poe-lab/InsightMaze/README.md

# InsightMaze
C++ code for running automated maze.
The code in this folder is pseudo code to practice 
with the different components of the insight maze.
