poe-lab/InsightMaze/MockMaze_run/README.txt

The code in this folder is pseudo code to practice 
with the different components of the insight maze

4/18/19

Tried rubber - caused too much friction, but did work as intended
	can try moving rubber farther away from door slot
	should show Greg tomorrow

There is one door slot that is too wide 
	can try connecting some rubber to make it work properly
