poe-lab/InsightMaze/Maze Parts/Module Floors/Main Module Floor.STEP

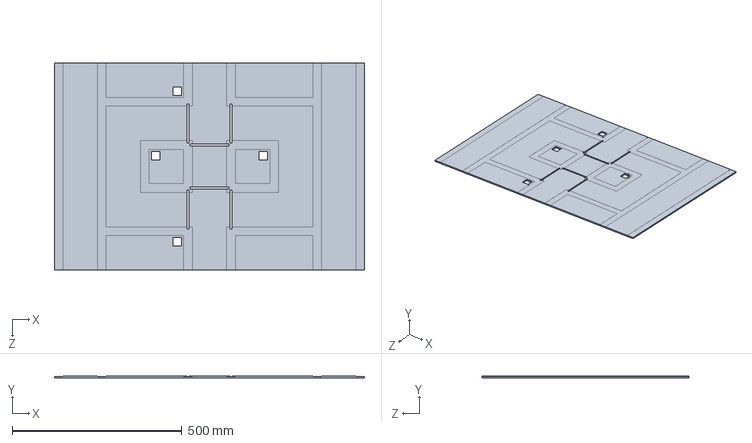
[picture p1: CAD file, 2019-07-17]
Maze Parts/Module Floors/Main Module Floor.STEP
914.4 x 4.76 x 609.6 mm
