poe-lab/InsightMaze/Maze Parts/Doors/Door Guide Rail Profile.dxf

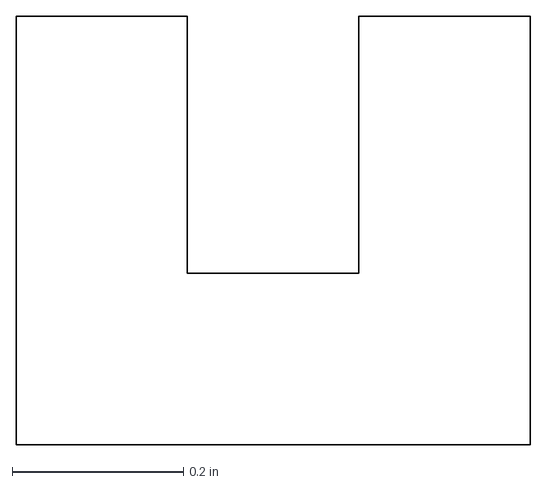
[picture p2: CAD file, 2019-07-17]
Maze Parts/Doors/Door Guide Rail Profile.dxf
0.6 x 0.5 in
