poe-lab/InsightMaze/Maze Parts/Joints and Braces/4 Way Wall Wall Joint Profile.dxf

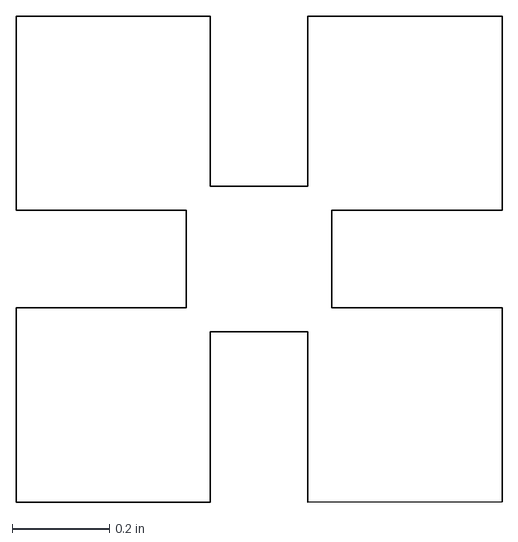
[picture p3: CAD file, 2019-07-17]
Maze Parts/Joints and Braces/4 Way Wall Wall Joint Profile.dxf
1 x 1.00 in
