poe-lab/InsightMaze/Maze Parts/Rewards Dispenser/Rewards Dispenser.STEP

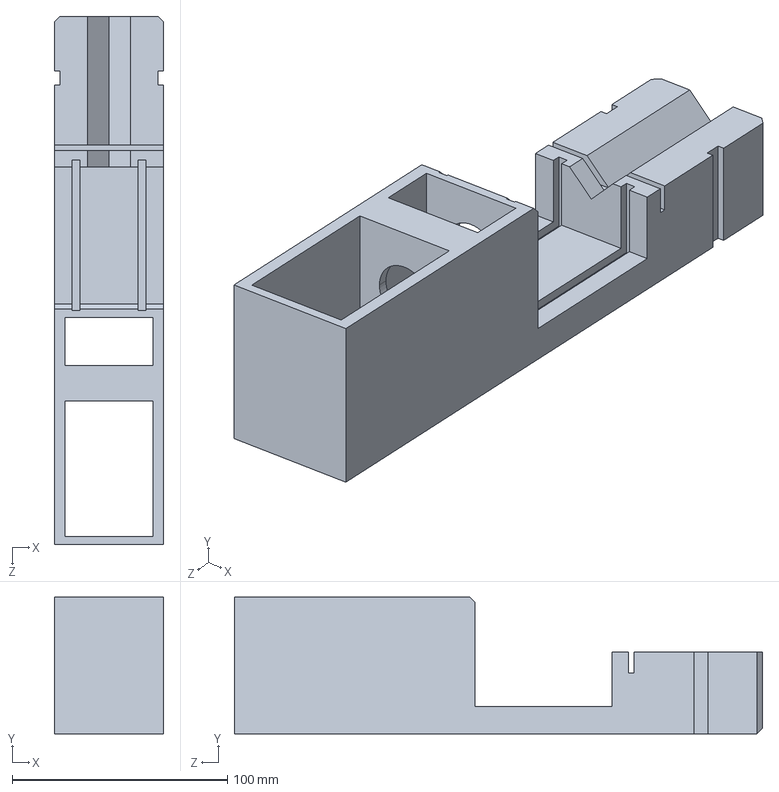
[picture p4: CAD file, 2019-07-17]
Maze Parts/Rewards Dispenser/Rewards Dispenser.STEP
50.8 x 63.5 x 245.1 mm
