poe-lab/InsightMaze/Maze Parts/Doors/Door Cap.STEP

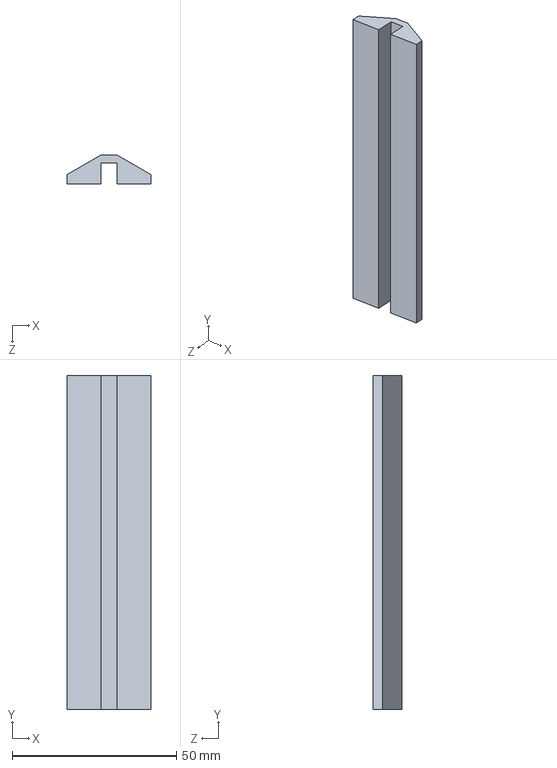
[picture p5: CAD file, 2019-07-17]
Maze Parts/Doors/Door Cap.STEP
25.4 x 101.6 x 8.89 mm
