poe-lab/InsightMaze/Maze Parts/Joints and Braces/2-Way Wall Brace.STEP

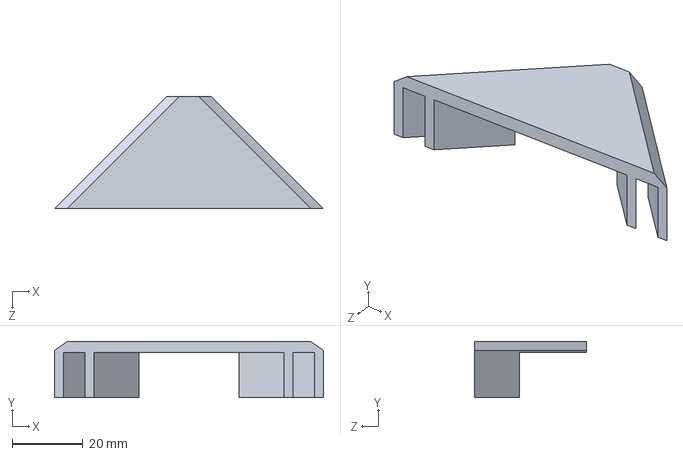
[picture p6: CAD file, 2019-07-17]
Maze Parts/Joints and Braces/2-Way Wall Brace.STEP
76.2 x 15.9 x 31.8 mm
