poe-lab/InsightMaze/Maze Parts/Module Floors/Start Module Floor.STEP

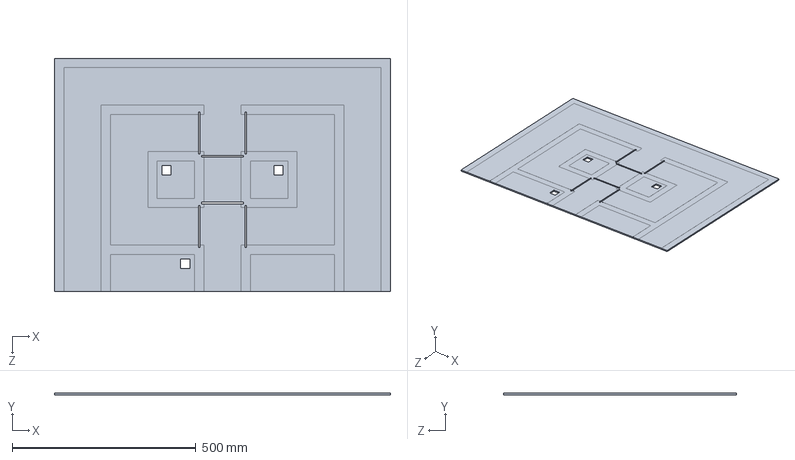
[picture p7: CAD file, 2019-07-17]
Maze Parts/Module Floors/Start Module Floor.STEP
914.4 x 4.76 x 635.0 mm
