poe-lab/InsightMaze/Maze Parts/Rewards Dispenser/Syringe Attachment.STEP

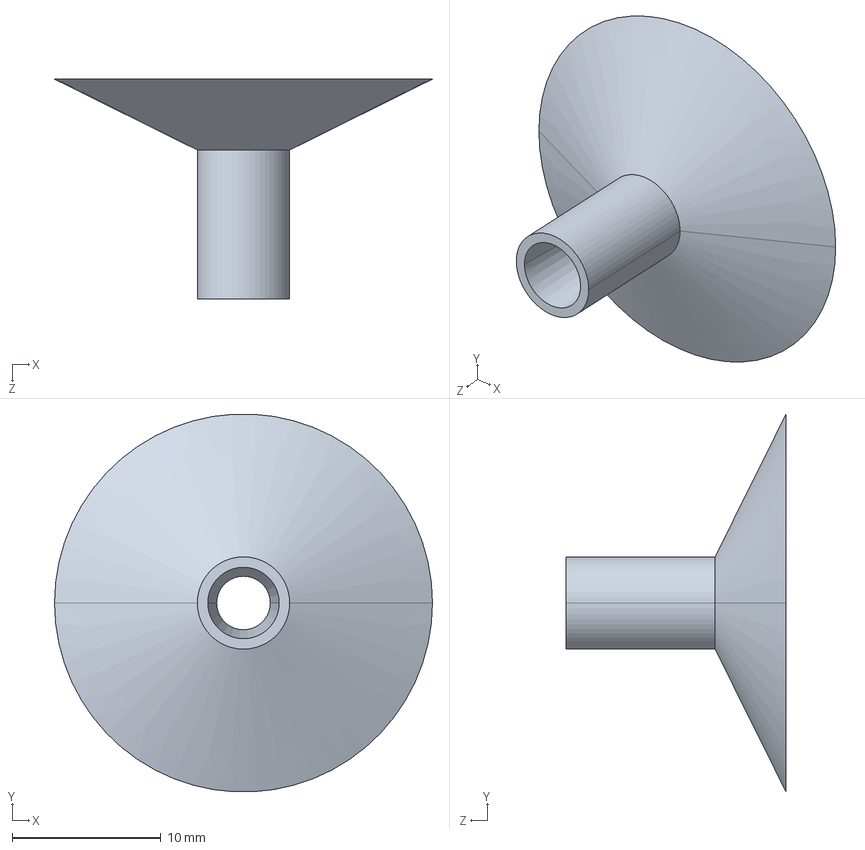
[picture p8: CAD file, 2019-07-17]
Maze Parts/Rewards Dispenser/Syringe Attachment.STEP
25.4 x 25.4 x 14.8 mm
