poe-lab/InsightMaze/Maze Parts/Doors/Door Arm Opposite Side.STEP

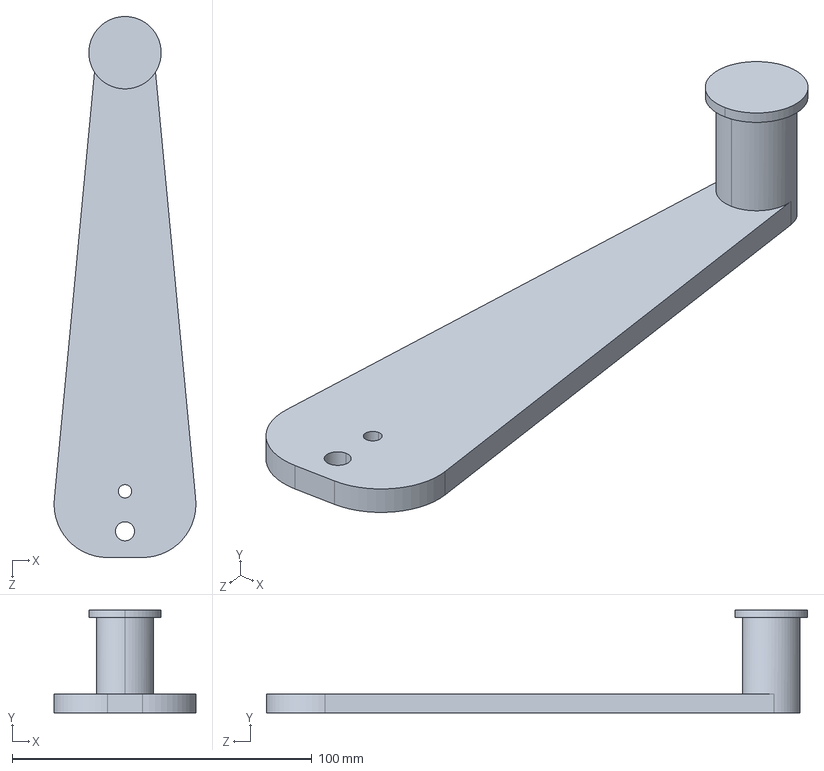
[picture p9: CAD file, 2019-07-17]
Maze Parts/Doors/Door Arm Opposite Side.STEP
47.3 x 34.3 x 180.3 mm
