poe-lab/InsightMaze/Maze Parts/Joints and Braces/3-Way Wall Brace.STEP

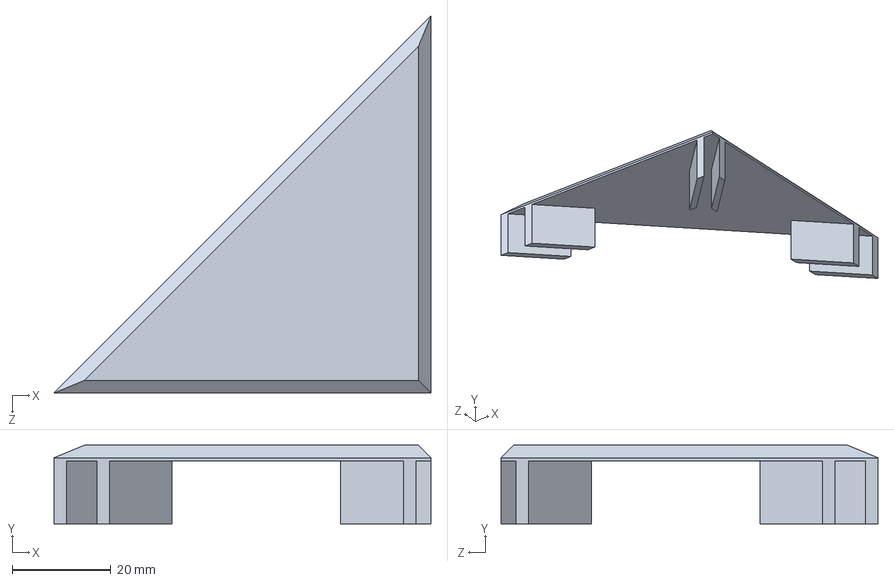
[picture p10: CAD file, 2019-07-17]
Maze Parts/Joints and Braces/3-Way Wall Brace.STEP
76.2 x 15.9 x 76.2 mm
