poe-lab/InsightMaze/Maze Parts/Rewards Dispenser/Wall for Rewards Dispenser.STEP

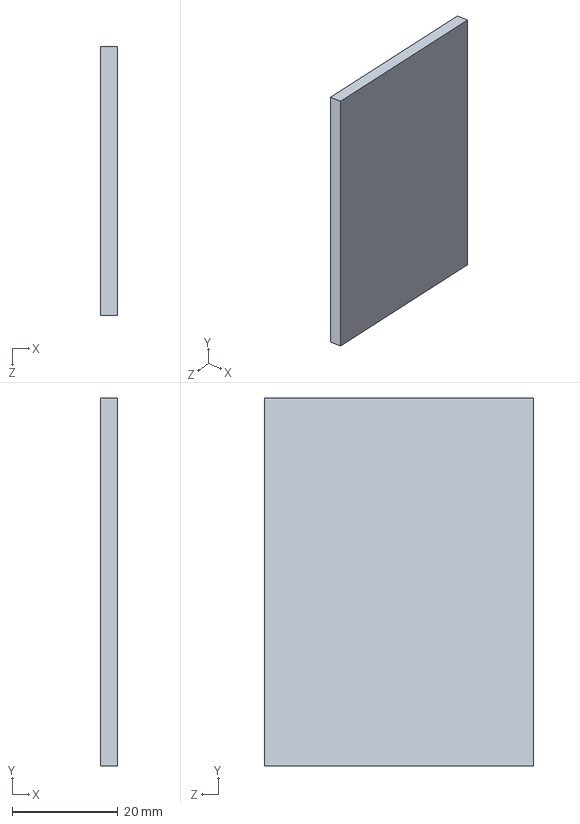
[picture p11: CAD file, 2019-07-17]
Maze Parts/Rewards Dispenser/Wall for Rewards Dispenser.STEP
3.17 x 69.6 x 50.8 mm
