poe-lab/InsightMaze/Maze Parts/Doors/Single Door Guide Rail Mount.step

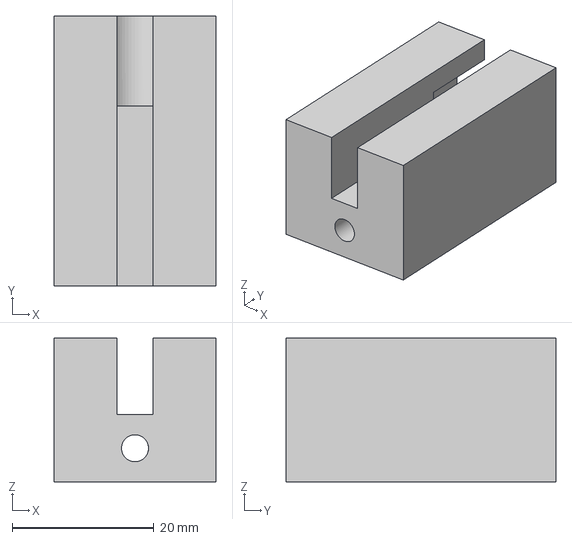
[picture p12: CAD file, 2019-07-17]
Maze Parts/Doors/Single Door Guide Rail Mount.step
22.9 x 38.1 x 20.3 mm
