poe-lab/InsightMaze/Maze Parts/Rewards Dispenser/Shim for Rewards Dispenser.STEP

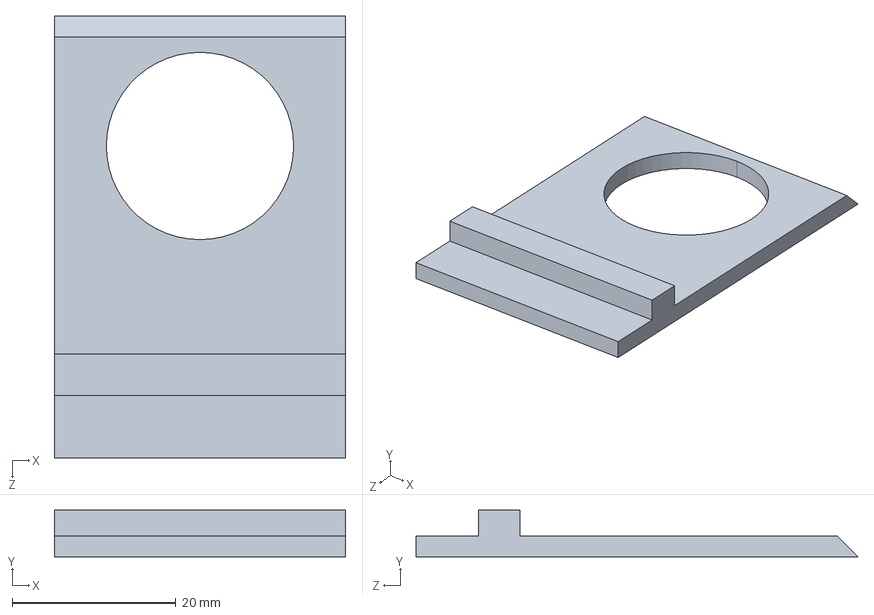
[picture p14: CAD file, 2019-07-17]
Maze Parts/Rewards Dispenser/Shim for Rewards Dispenser.STEP
35.6 x 5.71 x 54.0 mm
