poe-lab/InsightMaze/Maze Parts/Joints and Braces/3 Way Wall Wall Joint Profile.dxf

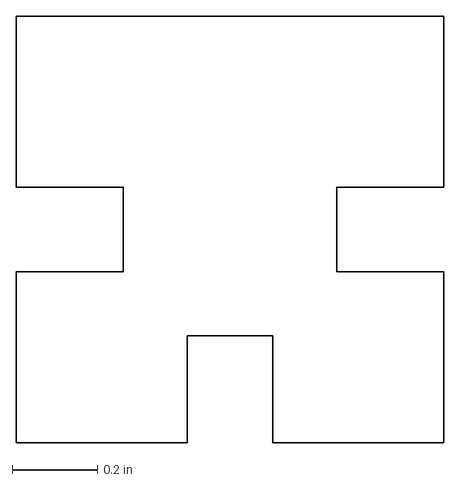
[picture p15: CAD file, 2019-07-17]
Maze Parts/Joints and Braces/3 Way Wall Wall Joint Profile.dxf
1.00 x 0.998 in
