poe-lab/InsightMaze/Maze Parts/Rewards Dispenser/Pusher for Rewards Dispenser.STEP

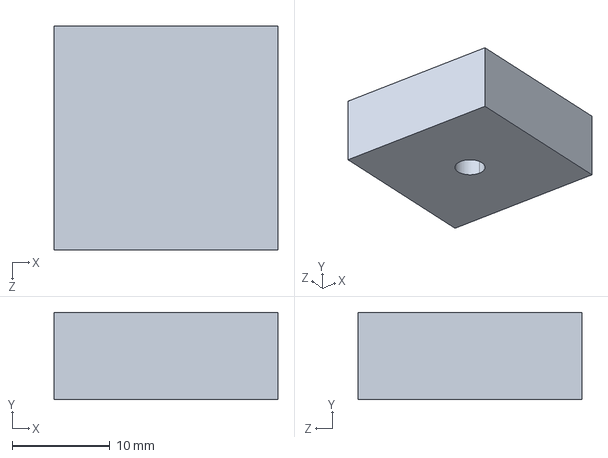
[picture p16: CAD file, 2019-07-17]
Maze Parts/Rewards Dispenser/Pusher for Rewards Dispenser.STEP
22.9 x 8.89 x 22.9 mm
