poe-lab/InsightMaze/Maze Parts/Joints and Braces/Floor Wall Joint Profile.dxf

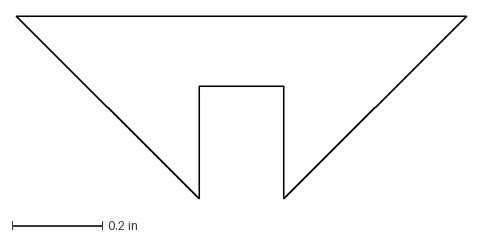
[picture p17: CAD file, 2019-07-17]
Maze Parts/Joints and Braces/Floor Wall Joint Profile.dxf
1 x 0.406 in
