poe-lab/InsightMaze/(list of files, cad)

Other CAD files:
Maze Parts/Module Floors/End Module Floor.STEP
Maze Parts/Doors/Door Arm Same Side.STEP
