poe-lab/InsightMaze/Insight_Maze_Master_Control_System/Insight_Maze_Master_Control_System.ino

#include "InsightMazeMaster.h"
#include "globals.h"

Master ma(PINS_ID_OUT, PIN_BTN, PIN_SD_CS, PIN_ALERT_IN);

void setup() {
  // put your setup code here, to run once:
  ma.masterSetup();
  attachInterrupt(digitalPinToInterrupt(ma.pinAlertIn()), sendPulse, CHANGE);
  
  pinMode(13, OUTPUT);
  digitalWrite(13, HIGH);
  pinMode(40, OUTPUT);
  pinMode(PIN_ALERT_OUT, OUTPUT);
  Serial.println("Waiting for button press...");
}

void loop() {
  // put your main code here, to run repeatedly:
  
  ma.sctProtocol(1);
  digitalWrite(40, HIGH);
  delay(2000);
  digitalWrite(40, LOW);

  
  Serial.println("Finished loop");

}

void sendPulse(){
  digitalWrite(PIN_ALERT_OUT, HIGH);
  delayMicroseconds(PULSE_DURATION);
  digitalWrite(PIN_ALERT_OUT, LOW);
}
