poe-lab/InsightMaze/Insight_Maze_Control_System/InsightMaze.cpp

#include <Arduino.h>
#include "InsightMaze.h"

//////////////////////////// MAIN MODULE CLASS ///////////////////////////////////////////

Module::Module(int pinID, Sensor s0, Sensor s1, Sensor s2, Sensor s3, Door d0, Door d1, Door d2, Door d3, Door d4, Door d5)
  : m_s0(s0), m_s1(s1), m_s2(s2), m_s3(s3), m_d0(d0), m_d1(d1), m_d2(d2), m_d3(d3), m_d4(d4), m_d5(d5) 
{
  m_pinID = pinID;
  
  m_s0 = s0;
  m_s1 = s1;
  m_s2 = s2;
  m_s3 = s3;
  m_sensors[0] = &m_s0;
  m_sensors[1] = &m_s1;
  m_sensors[2] = &m_s2;
  m_sensors[3] = &m_s3;

  m_d0 = d0;
  m_d1 = d1;
  m_d2 = d2;
  m_d3 = d3;
  m_d4 = d4;
  m_d5 = d5;
  m_doors[0] = &m_d0;
  m_doors[1] = &m_d1;
  m_doors[2] = &m_d2;
  m_doors[3] = &m_d3;
  m_doors[4] = &m_d4;
  m_doors[5] = &m_d5;
}

void Module::moduleSetup(){
  Serial.begin(9600);
  
  Serial.println("Setting Up Sensors...");
  // Calls setup fuinction for all sensors
  for(int i = 0; i < NUM_MAIN_SENSORS; i++)
    m_sensors[i]->sensorSetup();
    
  Serial.println("Setting Up Doors...");
  // Calls setup function for all doors
  for(int i = 0; i < NUM_MAIN_DOORS; i++)
    m_doors[i]->doorSetup();
  
  m_needsToConfig = true;

  Serial.println("Deteriming Module ID...");
  
  // Determines ID char of Module
  int idValIn = analogRead(m_pinID);
  Serial.print("ID Input Val: "); Serial.println(idValIn);
  
  char id = 'n';

  for(int i = 0; i < NUM_IDS; i++) {
    if(idValIn >= ID_VALS_IN[i] - ID_RES && idValIn <= ID_VALS_IN[i] + ID_RES)
      m_id = IDS[i];
  }
  Serial.print("Module ID: "); Serial.println(m_id);

  Serial.println("Testing Doors...");

  testDoors(1500, 1500);
}

void Module::openDoor(int doorID){
  m_doors[doorID]->doorOpen();
}

void Module::closeDoor(int doorID){
  m_doors[doorID]->doorClose();
}

bool Module::isDoorOpen(int doorID){
  return (m_doors[doorID]->isOpen());
}

void Module::openAllDoors(){
  for(int i = 0; i < NUM_MAIN_DOORS; i++) openDoor(i);
}

void Module::closeAllDoors(){
  for(int i = 0; i < NUM_MAIN_DOORS; i++) closeDoor(i);
}
    
void Module::testDoors(int closeTime, int openTime){
  closeAllDoors();
  delay(closeTime);
  openAllDoors();
  delay(openTime);
}

void Module::printDoorsStates() {
  Serial.print("dState:");
  for(int i = 0; i < NUM_MAIN_DOORS; i++){
    Serial.print(isDoorOpen(i));
    if(i == NUM_MAIN_DOORS - 1) Serial.print(" - ");
    else Serial.print(',');
  }
}

void Module::setPath(int path){
  switch (path){
    case LEFT:
      for(int i = 0; i < NUM_MAIN_DOORS; i++){
        if(i == 0 || i == 3) openDoor(i);
        else closeDoor(i);
      }
      break;

    case CENTER:
      for(int i = 0; i < NUM_MAIN_DOORS; i++){
        if(i == 1 || i == 4) openDoor(i);
        else closeDoor(i);
      }
      break;

    case RIGHT:
      for(int i = 0; i < NUM_MAIN_DOORS; i++){
        if(i == 2 || i == 5) openDoor(i);
        else closeDoor(i);
      }
      break;
  }
}

int Module::getSensorVal(int sensorID){
  return (m_sensors[sensorID]->getSensorVal());
}

void Module::updateSensors(){
  for(int i = 0; i < NUM_MAIN_SENSORS; i++){
    m_sensors[i]->sensorUpdate();
  }
}

bool Module::isSensorFall(int sensorID){
  return (m_sensors[sensorID]->isFallEdge());
}

bool Module::isSensorRise(int sensorID){
  return (m_sensors[sensorID]->isRiseEdge());
}

int Module::getSensorThresh(int sensorID){
  return (m_sensors[sensorID]->getThreshold());
}

bool Module::isObjInSensorView(int sensorID){
  return (m_sensors[sensorID]->isPastThresh());
}

bool Module::wasObjInSensorView(int sensorID){
  return (m_sensors[sensorID]->wasPastThresh());
}

void Module::printSensorsVals() {
  Serial.print("sVal:");
  for(int i = 0; i < NUM_MAIN_SENSORS; i++){
    Serial.print(getSensorVal(i));
    if(i == NUM_MAIN_SENSORS - 1) Serial.print(" - ");
    else Serial.print(',');
  }
}

void Module::printIsObjSensorView() {
  Serial.print("isObj:");
  for(int i = 0; i < NUM_MAIN_SENSORS; i++){
    Serial.print(isObjInSensorView(i));
    if(i == NUM_MAIN_SENSORS - 1) Serial.print(" - ");
    else Serial.print(',');
  }
}

void Module::printWasObjSensorView() {
  Serial.print("wasObj:");
  for(int i = 0; i < NUM_MAIN_SENSORS; i++){
    Serial.print(wasObjInSensorView(i));
    if(i == NUM_MAIN_SENSORS - 1) Serial.print(" - ");
    else Serial.print(',');
  }
}

void Module::printSensorsIsFall() {
  Serial.print("isFall:");
  for(int i = 0; i < NUM_MAIN_SENSORS; i++){
    Serial.print(isSensorFall(i));
    if(i == NUM_MAIN_SENSORS - 1) Serial.print(" - ");
    else Serial.print(',');
  }
}

void Module::printSensorsIsRise() {
  Serial.print("isRise:");
  for(int i = 0; i < NUM_MAIN_SENSORS; i++){
    Serial.print(isSensorRise(i));
    if(i == NUM_MAIN_SENSORS - 1) Serial.print(" - ");
    else Serial.print(',');
  }
}

void Module::printSensorsThresh(){
  Serial.print("sThresh:");
  for(int i = 0; i < NUM_MAIN_SENSORS; i++){
    Serial.print(getSensorThresh(i));
    if(i == NUM_MAIN_SENSORS - 1) Serial.print(" - ");
    else Serial.print(',');
  }
}

void Module::testSensors(int values) {
  if(bitRead(values, 0)) printSensorsVals();
  if(bitRead(values, 1)) printSensorsThresh();
  if(bitRead(values, 2)) printIsObjSensorView();
  if(bitRead(values, 3)) printWasObjSensorView();
  if(bitRead(values, 4)) printSensorsIsFall();
  if(bitRead(values, 5)) printSensorsIsRise();
  Serial.println(' ');
}

char Module::id(){
  return m_id;
}

unsigned int Module::receiveCommands() {
  String receiving = Serial.readStringUntil('\n');
  unsigned int recCommands = 0;
  char charCommands[25];
  String strCommands = "";
  
  if(receiving.length() == 25) {
    receiving.toCharArray(charCommands, 25);

    for(int i = 0; i < receiving.length(); i++)
      if(charCommands[i] == m_id){ 
        strCommands += charCommands[i+1];
        strCommands += charCommands[i+2];
        strCommands += charCommands[i+3];
        recCommands = strCommands.toInt();
      }
  }
  
  return recCommands;
}

void Module::interpretCommands(unsigned int commands){
  unsigned int protocol = (commands & 0b11000000) >> 6;
}

//////////////////////////////////////////////////////////////////////////


/////////////////// End Module Class ////////////////////////////////////
EndModule::EndModule(int pinID, int pinAlertOut, Sensor s0, Sensor s1, Sensor s2, Door d0, Door d1, Door d2, Door d3, Door d4, Door d5, SyringePump r0, SyringePump r1, SyringePump r2)
  : m_s0(s0), m_s1(s1), m_s2(s2), m_d0(d0), m_d1(d1), m_d2(d2), m_d3(d3), m_d4(d4), m_d5(d5), m_r0(r0), m_r1(r1), m_r2(r2)
{
  m_pinID = pinID;
  m_pinAlertOut = pinAlertOut;
  
  m_s0 = s0;
  m_s1 = s1;
  m_s2 = s2;
  m_sensors[0] = &m_s0;
  m_sensors[1] = &m_s1;
  m_sensors[2] = &m_s2;

  m_d0 = d0;
  m_d1 = d1;
  m_d2 = d2;
  m_d3 = d3;
  m_d4 = d4;
  m_d5 = d5;
  m_doors[0] = &m_d0;
  m_doors[1] = &m_d1;
  m_doors[2] = &m_d2;
  m_doors[3] = &m_d3;
  m_doors[4] = &m_d4;
  m_doors[5] = &m_d5;

  m_r0 = r0;
  m_r1 = r1;
  m_r2 = r2;
  m_syringePumps[0] = &m_r0;
  m_syringePumps[1] = &m_r1;
  m_syringePumps[2] = &m_r2;
}

void EndModule::moduleSetup(){
  Serial.begin(9600);
  // Calls setup fuinction for all sensors
  Serial.println("Setting up sensors...");
  for(int i = 0; i < NUM_END_SENSORS; i++)
    m_sensors[i]->sensorSetup();
  
  // Calls setup function for all doors
  Serial.println("Setting up doors...");
  for(int i = 0; i < NUM_END_DOORS; i++)
    m_doors[i]->doorSetup();

  Serial.println("Setting up syringe pumps...");
  for(int i = 0; i < NUM_END_SYRINGE_PUMPS; i++){
    m_syringePumps[i]->syringeSetup();
  }
  m_needsToConfig = true;

  Serial.println("Deteriming Module ID...");
  
  // Determines ID char of Module
  int idValIn = analogRead(m_pinID);
  Serial.print("ID Input Val: "); Serial.println(idValIn);
  
  char id = 'n';

  for(int i = 0; i < NUM_IDS; i++) {
    if(idValIn >= ID_VALS_IN[i] - ID_RES && idValIn <= ID_VALS_IN[i] + ID_RES)
      m_id = IDS[i];
  }
  Serial.print("Module ID: "); Serial.println(m_id);

  Serial.println("Testing Doors...");

  testDoors(1500, 1500);
}

void EndModule::openDoor(int doorID){
  m_doors[doorID]->doorOpen();
}

void EndModule::closeDoor(int doorID){
  m_doors[doorID]->doorClose();
}

bool EndModule::isDoorOpen(int doorID){
  return (m_doors[doorID]->isOpen());
}

void EndModule::openAllDoors(){
  for(int i = 0; i < NUM_END_DOORS; i++) openDoor(i);
}

void EndModule::closeAllDoors(){
  for(int i = 0; i < NUM_END_DOORS; i++) closeDoor(i);
}
    
void EndModule::testDoors(int closeTime, int openTime){
  closeAllDoors();
  delay(closeTime);
  openAllDoors();
  delay(openTime);
}

void EndModule::printDoorsStates() {
  Serial.print("dState:");
  for(int i = 0; i < NUM_END_DOORS; i++){
    Serial.print(isDoorOpen(i));
    if(i == NUM_END_DOORS - 1) Serial.print(" - ");
    else Serial.print(',');
  }
}

void EndModule::setPath(int path){
  switch (path){
    case LEFT:
      for(int i = 0; i < NUM_END_DOORS; i++){
        if(i == 0 || i == 3) openDoor(i);
        else closeDoor(i);
      }
      break;

    case CENTER:
      for(int i = 0; i < NUM_END_DOORS; i++){
        if(i == 1 || i == 4) openDoor(i);
        else closeDoor(i);
      }
      break;

    case RIGHT:
      for(int i = 0; i < NUM_END_DOORS; i++){
        if(i == 2 || i == 5) openDoor(i);
        else closeDoor(i);
      }
      break;
  }
}

int EndModule::getSensorVal(int sensorID){
  return (m_sensors[sensorID]->getSensorVal());
}

void EndModule::updateSensors(){
  for(int i = 0; i < NUM_END_SENSORS; i++){
    m_sensors[i]->sensorUpdate();
  }
}

bool EndModule::isSensorFall(int sensorID){
  return (m_sensors[sensorID]->isFallEdge());
}

bool EndModule::isSensorRise(int sensorID){
  return (m_sensors[sensorID]->isRiseEdge());
}

int EndModule::getSensorThresh(int sensorID){
  return (m_sensors[sensorID]->getThreshold());
}

bool EndModule::isObjInSensorView(int sensorID){
  return (m_sensors[sensorID]->isPastThresh());
}

bool EndModule::wasObjInSensorView(int sensorID){
  return (m_sensors[sensorID]->wasPastThresh());
}

void EndModule::printSensorsVals() {
  Serial.print("sVal:");
  for(int i = 0; i < NUM_END_SENSORS; i++){
    Serial.print(getSensorVal(i));
    if(i == NUM_END_SENSORS - 1) Serial.print(" - ");
    else Serial.print(',');
  }
}

void EndModule::printIsObjSensorView() {
  Serial.print("isObj:");
  for(int i = 0; i < NUM_END_SENSORS; i++){
    Serial.print(isObjInSensorView(i));
    if(i == NUM_END_SENSORS - 1) Serial.print(" - ");
    else Serial.print(',');
  }
}

void EndModule::printWasObjSensorView() {
  Serial.print("wasObj:");
  for(int i = 0; i < NUM_END_SENSORS; i++){
    Serial.print(wasObjInSensorView(i));
    if(i == NUM_END_SENSORS - 1) Serial.print(" - ");
    else Serial.print(',');
  }
}

void EndModule::printSensorsIsFall() {
  Serial.print("isFall:");
  for(int i = 0; i < NUM_END_SENSORS; i++){
    Serial.print(isSensorFall(i));
    if(i == NUM_END_SENSORS - 1) Serial.print(" - ");
    else Serial.print(',');
  }
}

void EndModule::printSensorsIsRise() {
  Serial.print("isRise:");
  for(int i = 0; i < NUM_END_SENSORS; i++){
    Serial.print(isSensorRise(i));
    if(i == NUM_END_SENSORS - 1) Serial.print(" - ");
    else Serial.print(',');
  }
}

void EndModule::printSensorsThresh(){
  Serial.print("sThresh:");
  for(int i = 0; i < NUM_END_SENSORS; i++){
    Serial.print(getSensorThresh(i));
    if(i == NUM_END_SENSORS - 1) Serial.print(" - ");
    else Serial.print(',');
  }
}

void EndModule::testSensors(int values) {
  if(bitRead(values, 0)) printSensorsVals();
  if(bitRead(values, 1)) printSensorsThresh();
  if(bitRead(values, 2)) printIsObjSensorView();
  if(bitRead(values, 3)) printWasObjSensorView();
  if(bitRead(values, 4)) printSensorsIsFall();
  if(bitRead(values, 5)) printSensorsIsRise();
  Serial.println(' ');
}

char EndModule::id(){
  return m_id;
}

unsigned int EndModule::receiveCommands() {
  String receiving = Serial.readStringUntil('\n');
  unsigned int recCommands = 0;
  char charCommands[25];
  String strCommands = "";
  
  if(receiving.length() == 25) {
    receiving.toCharArray(charCommands, 25);

    for(int i = 0; i < receiving.length(); i++)
      if(charCommands[i] == m_id){ 
        strCommands += charCommands[i+1];
        strCommands += charCommands[i+2];
        strCommands += charCommands[i+3];
        recCommands = strCommands.toInt();
      }
  }
  
  return recCommands;
}

void EndModule::interpretCommands(unsigned int commands){
  unsigned int protocol = (commands & 0b11000000) >> 6;
}

void EndModule::dispenseReward(int syringePumpID, float vol){
  m_syringePumps[syringePumpID]->dispenseMilliliters(vol);
}
