poe-lab/InsightMaze/MockMaze_run/globals.h

#ifndef GLOBAL_H
#define GLOBAL_H

const int PIN_ID = A7;

const int PIN_SENSOR_0 = A0;
const int PIN_SENSOR_1 = A1;
const int PIN_SENSOR_2 = A2;
const int PIN_SENSOR_3 = A3;

const int PIN_DOOR_0 = 3;
const int PIN_DOOR_1 = 5;
const int PIN_DOOR_2 = 6;
const int PIN_DOOR_3 = 9;
const int PIN_DOOR_4 = 10;
const int PIN_DOOR_5 = 11;

const int POS_D0[] = {150, 50};
const int POS_D1[] = {50, 160};
const int POS_D2[] = {45, 160};
const int POS_D3[] = {150, 50};
const int POS_D4[] = {90, 0};
const int POS_D5[] = {150, 50};


#endif // GLOBAL_H
