poe-lab/InsightMaze/Insight_Maze_Master_Control_System/globals.h

#ifndef GLOBAL_H
#define GLOBAL_H

const int PINS_ID_OUT[] = {9, 8, 7, 6, 5, 3};
#define PIN_BTN 25
#define PIN_SD_CS 4
#define PIN_ALERT_IN 20
#define PIN_ALERT_OUT_0 13 // Change to 42
#define PIN_ALERT_OUT_1 34 
#define PULSE_DURATION 1000000

#endif // GLOBAL_H
