poe-lab/InsightMaze/Insight_Maze_Control_System/Door.h

#include <Servo.h>

class Door{
  public:
  Door(int pin, int posOpen, int posClose);
  void doorSetup();
  void doorOpen();
  void doorClose();
  bool isOpen();
  
  private:
  int m_pin;
  bool m_isOpen;
  int m_posOpen;
  int m_posClose;
  Servo m_servo;
};
