poe-lab/InsightMaze/(commit log)

2019-04-25 Reorganized syringe and communication functionin .ino
2019-04-26 Added messages for calibration of module.
2019-05-01 Changed sensor threshold
2019-05-08 Added function for leds to represent doors
2019-05-09 Added files for controlling master Arduino
2019-05-23 Fixed splitPathCommands() function in Master class
    [InsightMaze.cpp, InsightMaze.h, InsightMazeMaster.cpp, InsightMazeMaster.h, Insight_Maze_Control_System.ino, Insight_Maze_Master_Control_System.ino, Sensor.h, SyringePump.h]
2019-06-05 Editted End Module Class and Incorporated Interrupt
2019-06-05 Worked on interrupt
2019-06-13 Create Master Shield.brd
    [Master Shield.brd]
2019-07-17 Added folder for maze parts and added releant info to manual.
    [2 Way Wall Wall Joint Profile.dxf, 2-Way Wall Brace.STEP, 3 Way Wall Wall Joint Profile.dxf, 3-Way Wall Brace.STEP, 4 Way Wall Wall Joint Profile.dxf, Door Arm Opposite Side.STEP, Door Arm Same Side.STEP, Door Cap.STEP]
